bilskyi/yeti-keychain/case/yeti/latest/README.txt

ЙЕТИ-БРЕЛОК: 3 кнопки на животе + аккумулятор
================================================

Ремикс йети из проекта Compagnon 309 (MakerWorld, модель 2109424).
Только для себя: перед публикацией проверь лицензию на странице модели.
Подставка (диск со снегом и стойка) не входит, как просил.

ЧТО ПЕЧАТАТЬ  (папка print/)
----------------------------
Все файлы уже повёрнуты так, как их класть на стол. Не крути их в слайсере.

  Файл                                   Шт.  Поддержки
  1_body_with_3_buttons.stl               1   да, как у оригинала (*)
  2_back_plate_1xUSB-C_switch.stl         1   нет
  4_button_caps_x3.stl                    1   нет (3 колпачка в файле)
  5_screen_bezel_1.3in_original.stl       1   нет (оригинальная рамка экрана 1,3")

(*) Оригинальный корпус сам по себе требует поддержек внутри.
    Карманы под кнопки новых не добавляют.

Настройки: PLA или PETG, слой 0,2 мм, 3 периметра, заполнение 15-20 %.
Колпачки кнопок удобно печатать контрастным цветом.

ЧТО ПОНАДОБИТСЯ
---------------
  - ESP32-C3 Super Mini
  - OLED 1,3" 128x64 I2C (SH1106), 4 пина
  - плата зарядки TP4056 с USB-C и защитой DW01
  - LiPo-аккумулятор, не больше 20 x 33 x 6 мм (например 602030, 300 мА·ч)
  - движковый выключатель (SS12D00 или похожий)
  - 3 тактовые кнопки 6x6x5 мм
  - винты задней крышки к корпусу: как в оригинале
  - провода, термоусадка, немного клея и двусторонний скотч

СБОРКА
------
 1. Кнопки: вставь каждую в карман на животе снаружи, ножками в прорези.
    Если сидит свободно, капни клея на бок. Изнутри припаяй провода.
    Надень колпачки на штоки.
 2. Экран: рамку 5_screen_bezel вставь в окно корпуса изнутри, за ней экран
    стеклом к рамке.
 3. Электроника (рамки нет, крепи на клей и двусторонний скотч):
    TP4056 разъёмом USB-C в нижний карман задней крышки, разъём заподлицо
    с отверстием. Super Mini внутри, его USB-C наружу не выходит.
    Аккумулятор на скотч, выключатель в гнездо сбоку.
 4. Пропаяй всё по схеме ниже. Закрой крышку оригинальными винтами.

Сзади один USB-C: для зарядки (TP4056). Для прошивки сними заднюю крышку.

СХЕМА
-----
  OLED:      VCC -> 3V3, GND -> GND, SDA -> GPIO6, SCL -> GPIO7
  Кнопки:    GPIO1, GPIO3, GPIO5, вторая ножка каждой на GND
  Питание:   LiPo -> TP4056 B+/B-;  OUT+ -> выключатель -> 5V;  OUT- -> GND

  Прошивка наша (KEYCHAIN), не оригинальная от автора йети: у него другие пины.

ВАЖНО
-----
  - Никогда не втыкай USB в Super Mini при включённом выключателе: 5 В уйдут
    в аккумулятор. Перед прошивкой открой крышку и поставь выключатель OFF.
  - На TP4056 поменяй резистор Rprog с 1,2 кОм на 4,7-5,1 кОм. Иначе ток
    зарядки около 1 А, это слишком много для маленького аккумулятора.
  - Размеры TP4056, аккумулятора, выключателя и деталей на платах взяты
    типовые, а не измеренные. Если твои отличаются больше чем на 0,5 мм,
    пришли замеры, и я пересчитаю крышку.
