bilskyi/yeti-keychain/case/out/back.png

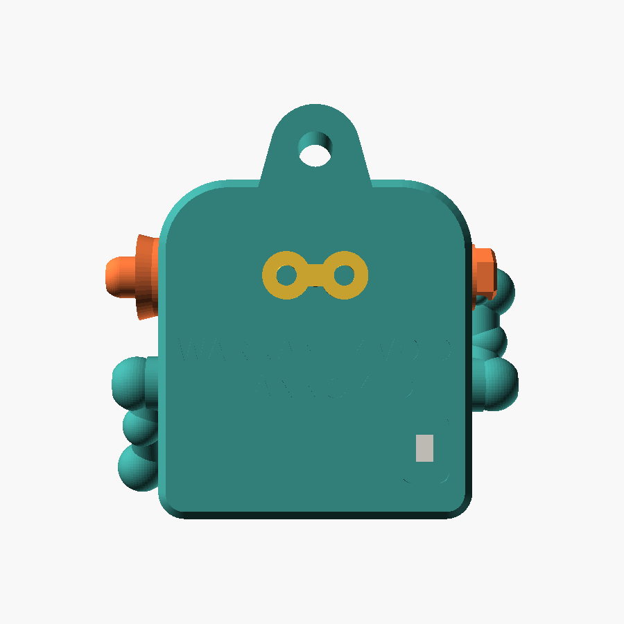
case/out/back.png
