bilskyi/yeti-keychain/case/out/concepts/arcade.png

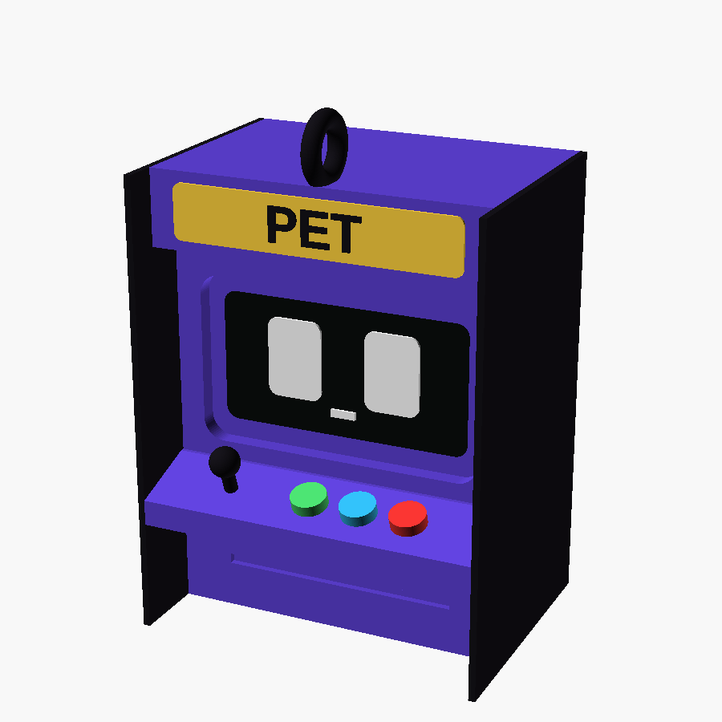
case/out/concepts/arcade.png
