bilskyi/yeti-keychain/case/out/concepts/burger.png

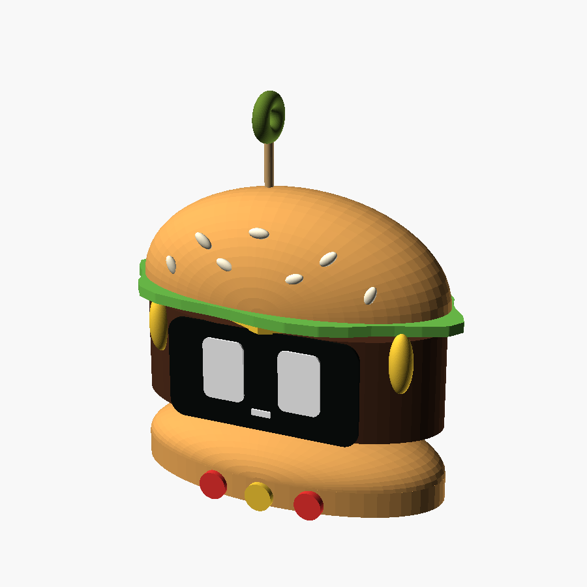
case/out/concepts/burger.png
