bilskyi/yeti-keychain/case/out/concepts/cassette.png

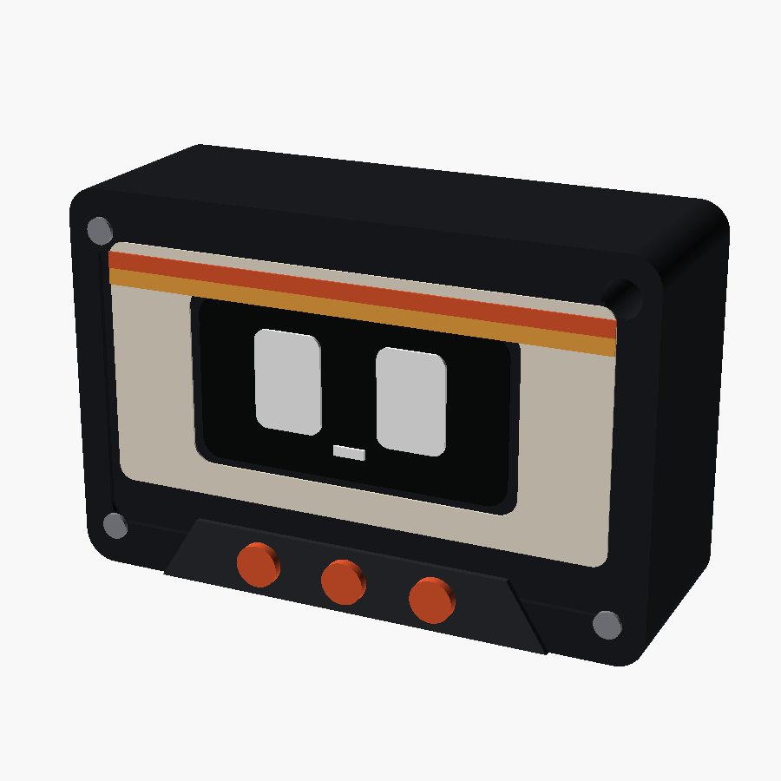
case/out/concepts/cassette.png
