bilskyi/yeti-keychain/case/out/concepts/cat.png

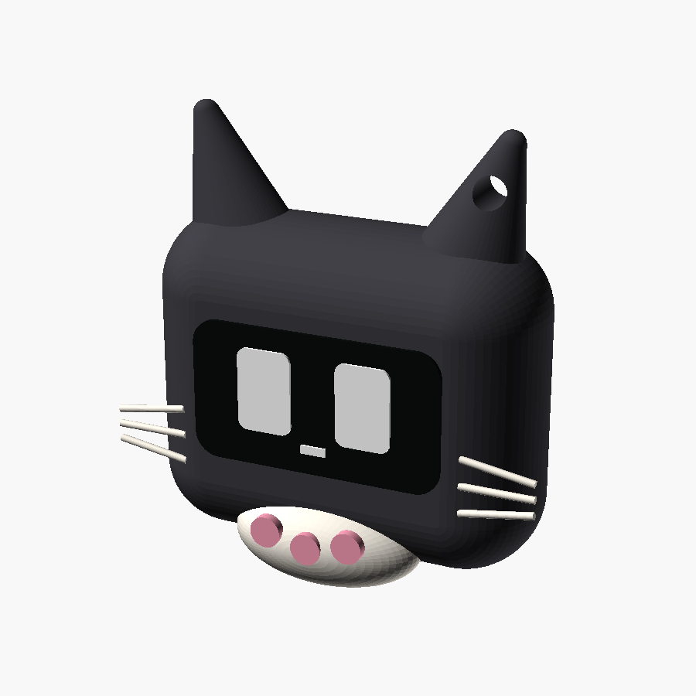
case/out/concepts/cat.png
