bilskyi/yeti-keychain/case/out/concepts/ghost.png

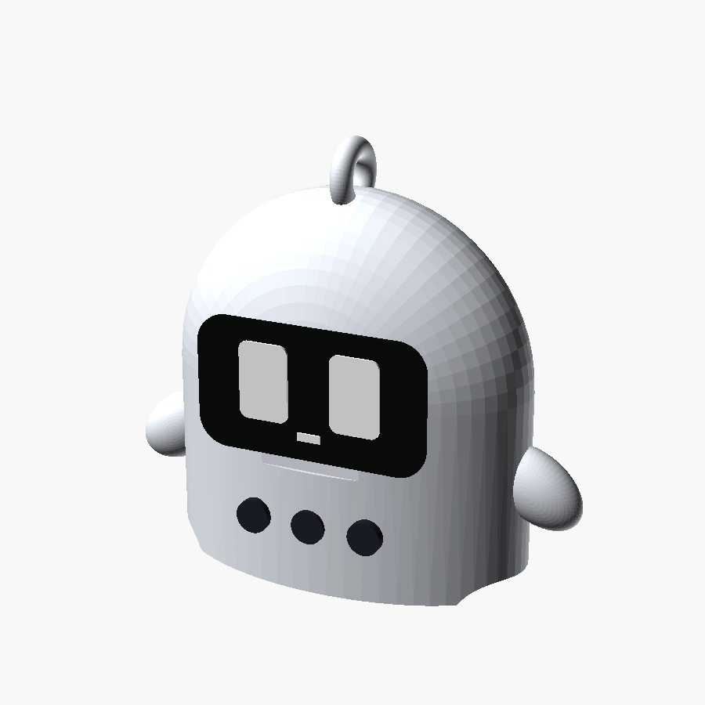
case/out/concepts/ghost.png
