bilskyi/yeti-keychain/case/out/concepts/helmet.png

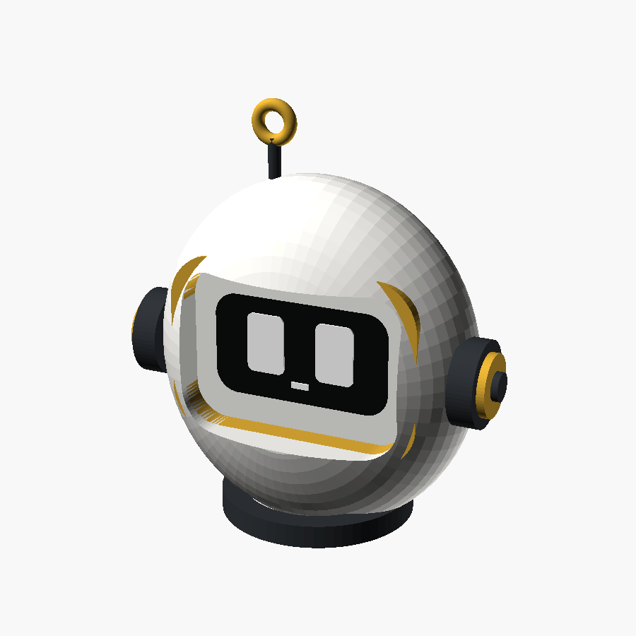
case/out/concepts/helmet.png
