bilskyi/yeti-keychain/case/out/concepts/poop.png

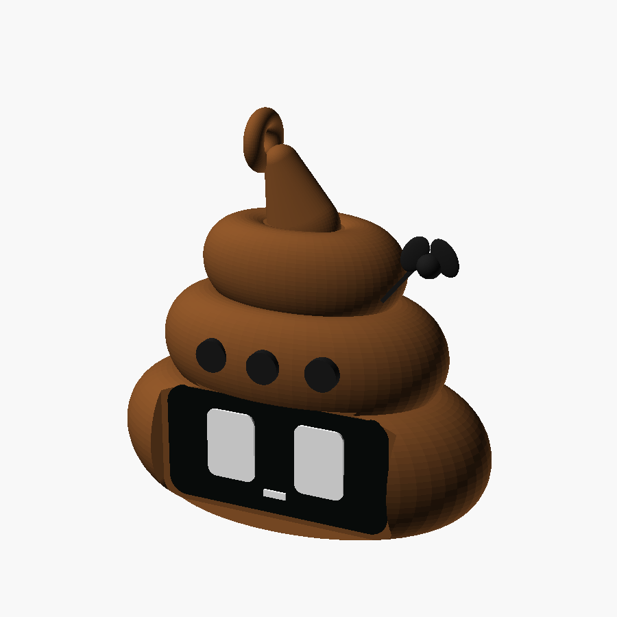
case/out/concepts/poop.png
