bilskyi/yeti-keychain/case/out/concepts/toast.png

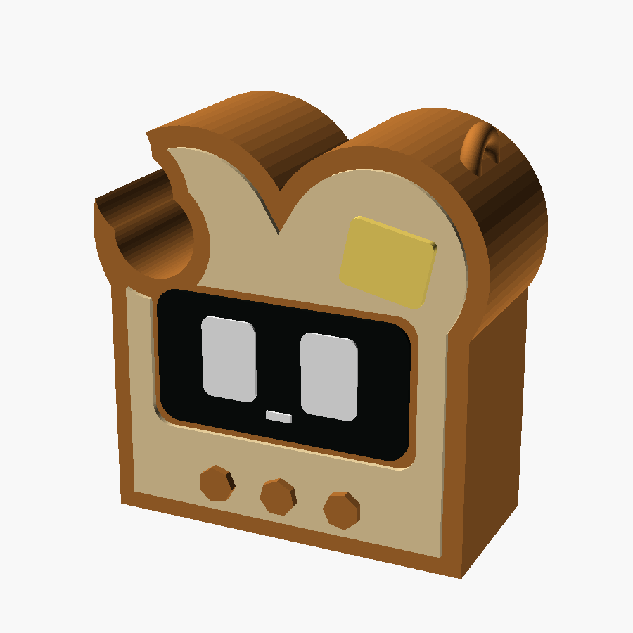
case/out/concepts/toast.png
