bilskyi/yeti-keychain/case/out/concepts/tv.png

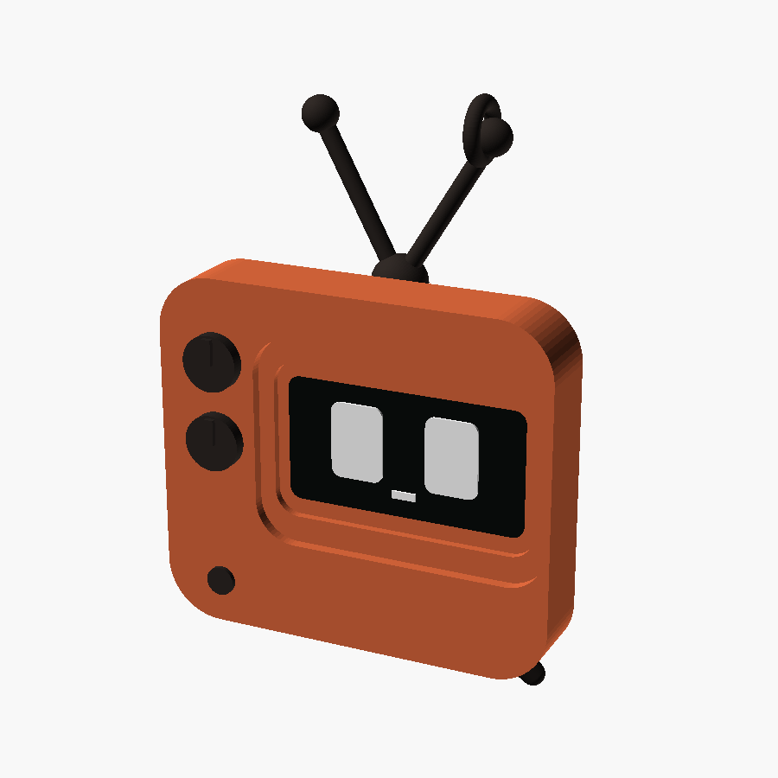
case/out/concepts/tv.png
