bilskyi/yeti-keychain/case/out/front.png

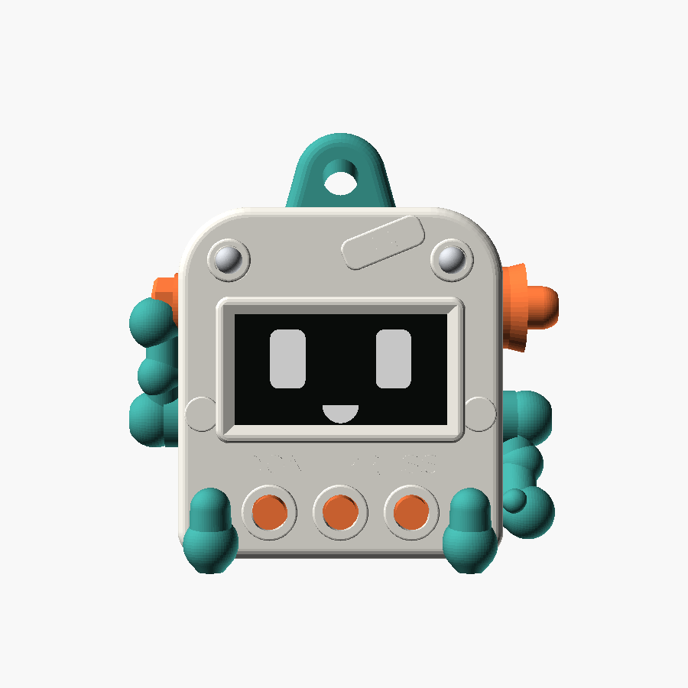
case/out/front.png
