bilskyi/yeti-keychain/case/out/hero.png

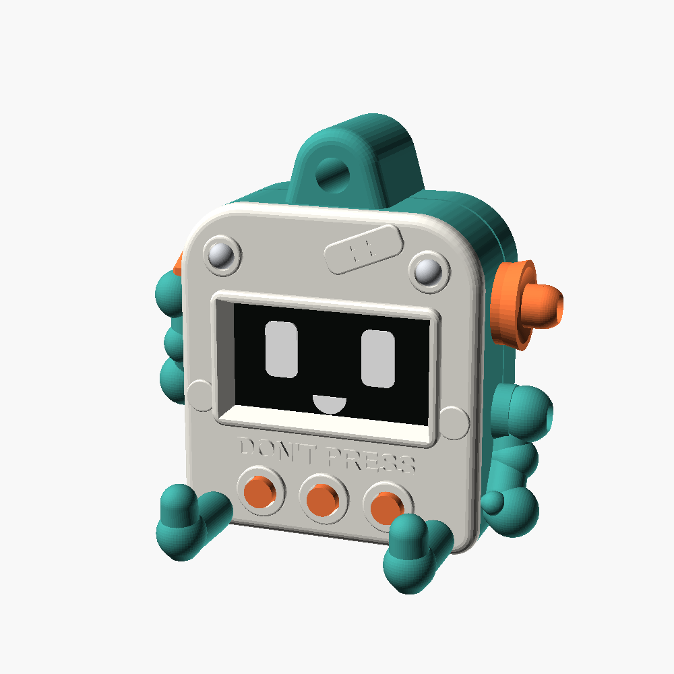
case/out/hero.png
