bilskyi/yeti-keychain/case/out/hero_rest.png

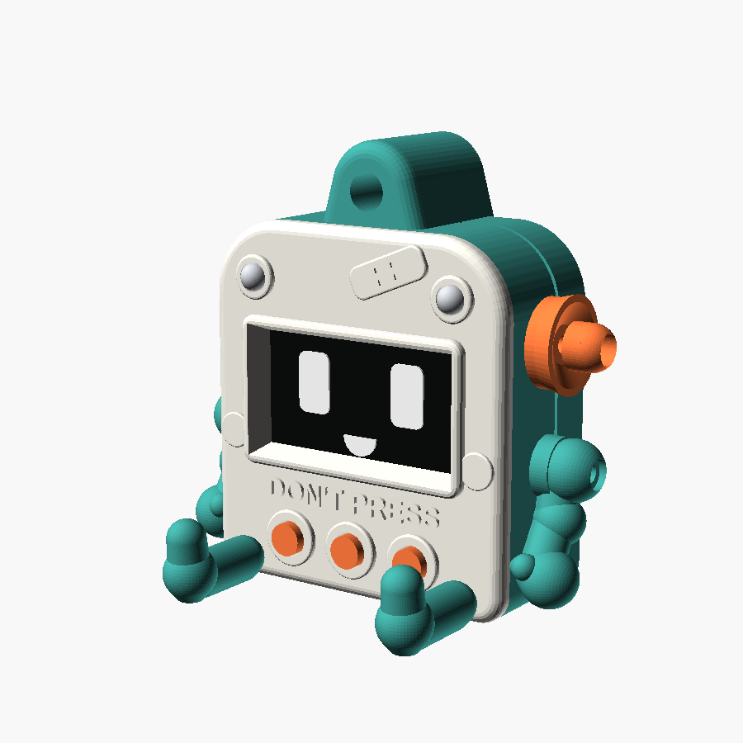
case/out/hero_rest.png
