bilskyi/yeti-keychain/case/out/side.png

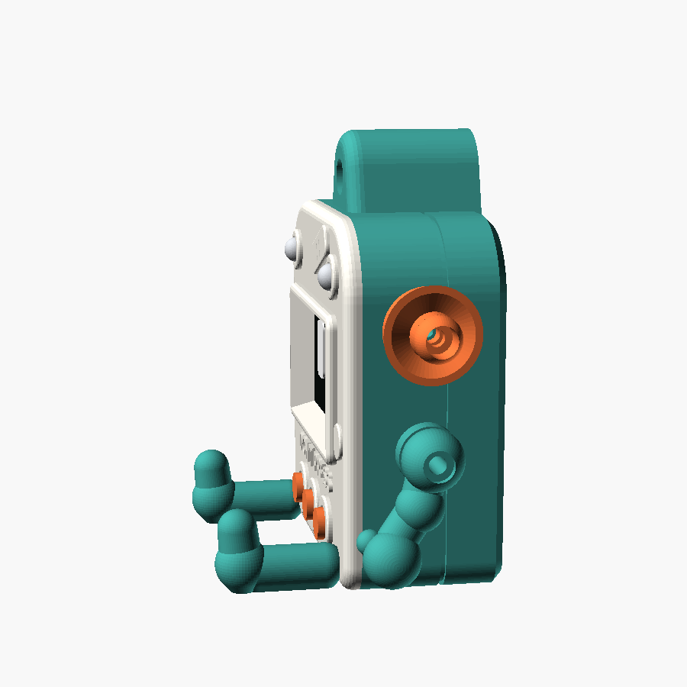
case/out/side.png
