bilskyi/yeti-keychain/case/yeti/out/look_back.png

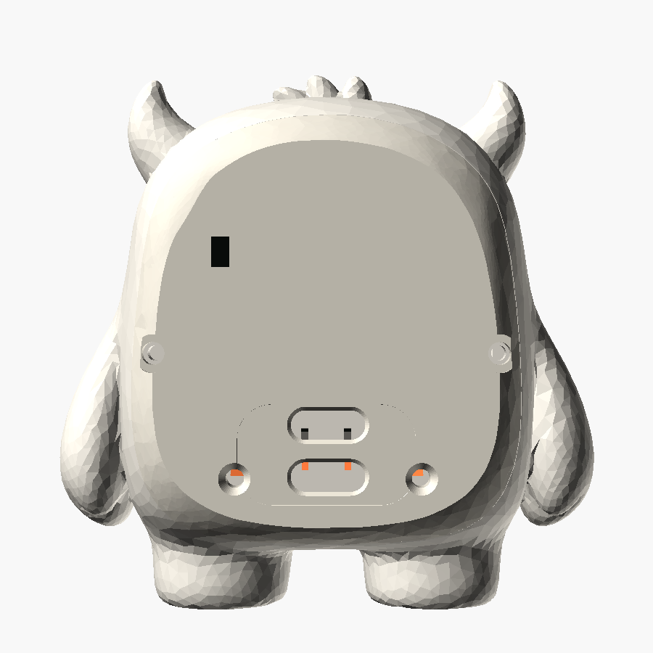
case/yeti/out/look_back.png
