bilskyi/yeti-keychain/case/yeti/out/look_bezel.png

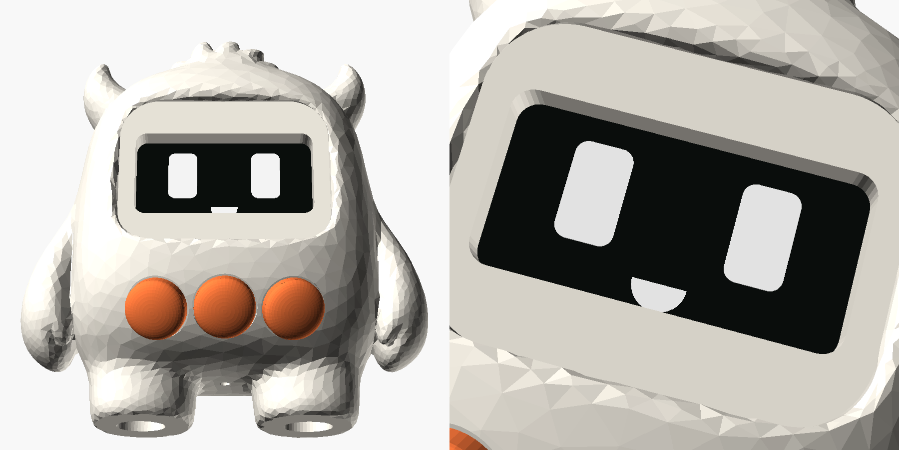
case/yeti/out/look_bezel.png
