bilskyi/yeti-keychain/case/yeti/out/look_closeup.png

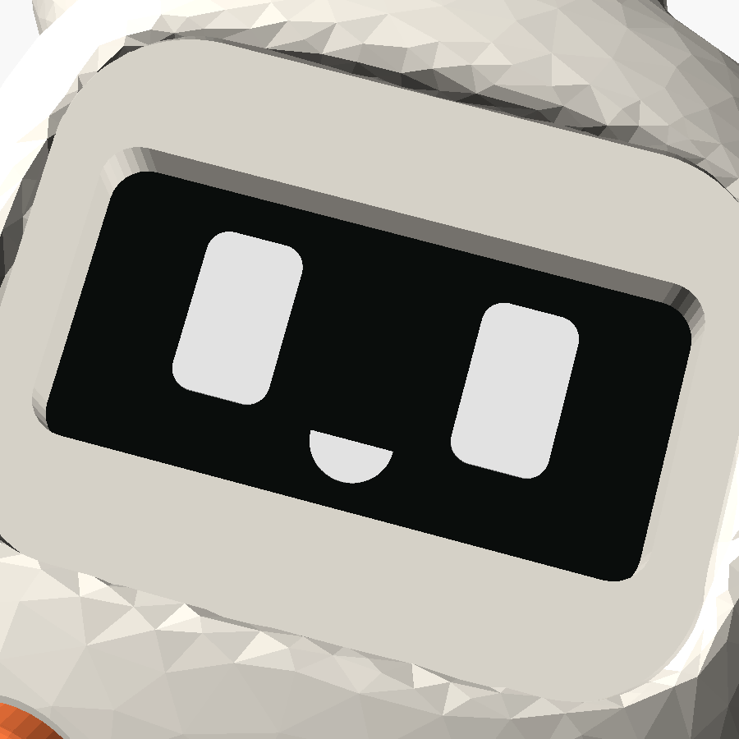
case/yeti/out/look_closeup.png
