bilskyi/yeti-keychain/case/yeti/out/look_front34.png

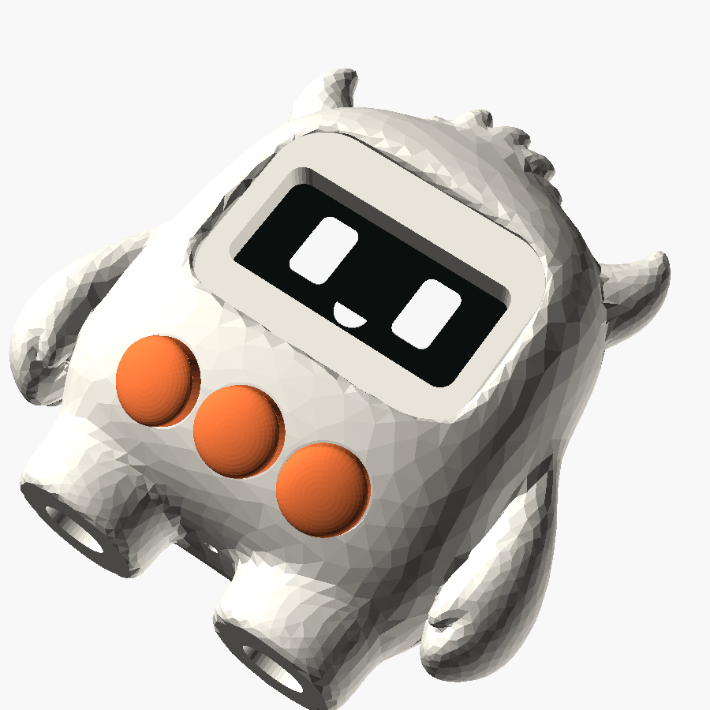
case/yeti/out/look_front34.png
