bilskyi/yeti-keychain/case/yeti/out/look_front.png

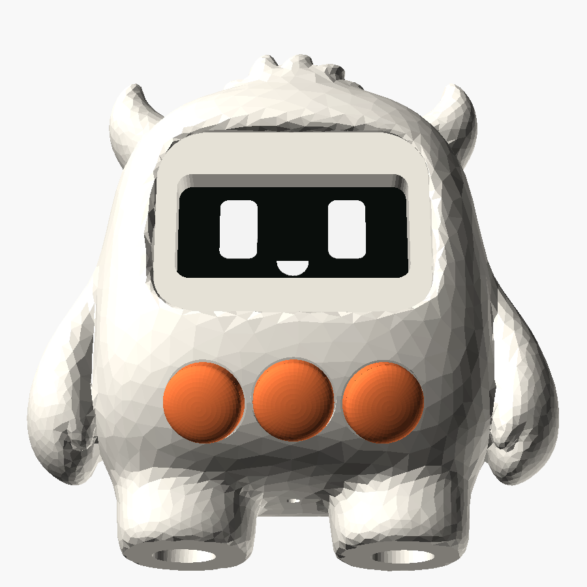
case/yeti/out/look_front.png
