bilskyi/yeti-keychain/case/yeti/out/look_others.png

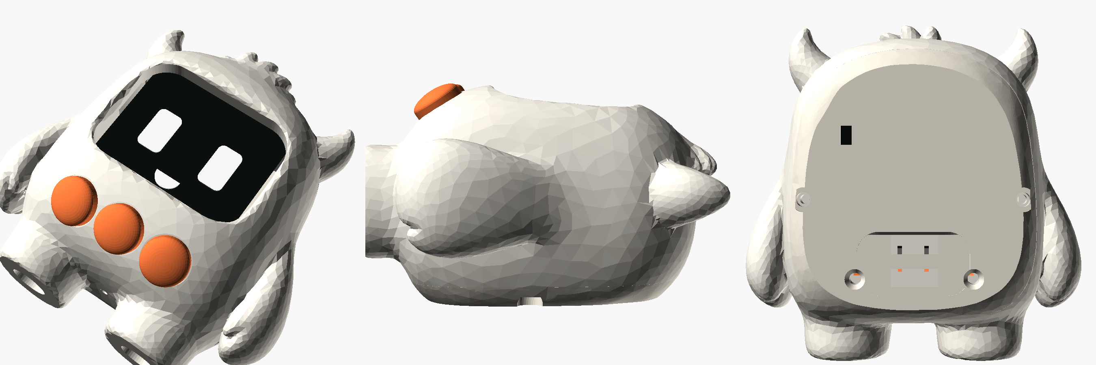
case/yeti/out/look_others.png
