bilskyi/yeti-keychain/case/yeti/out/look_side.png

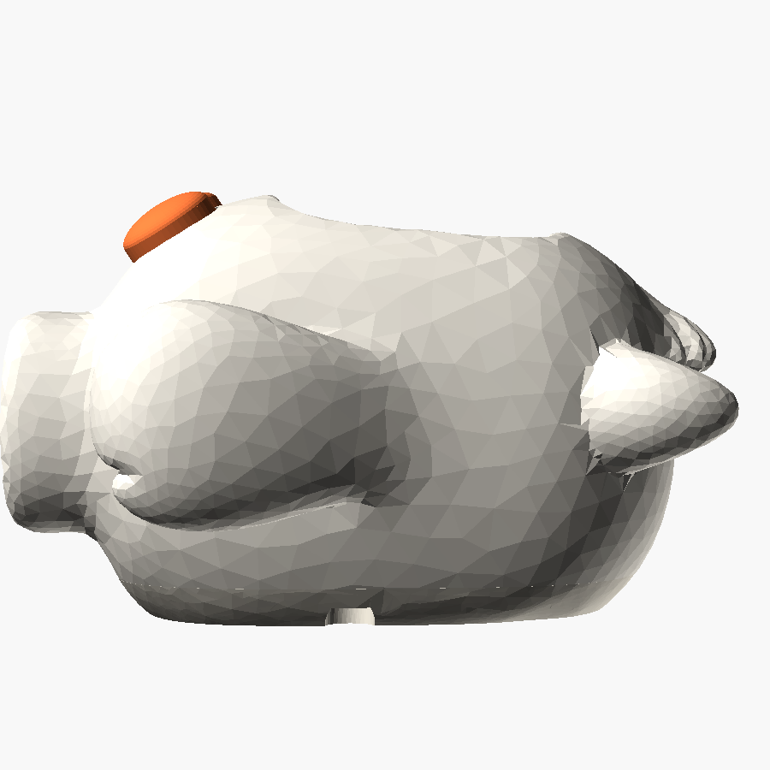
case/yeti/out/look_side.png
