bilskyi/yeti-keychain/case/yeti/out/module_back.png

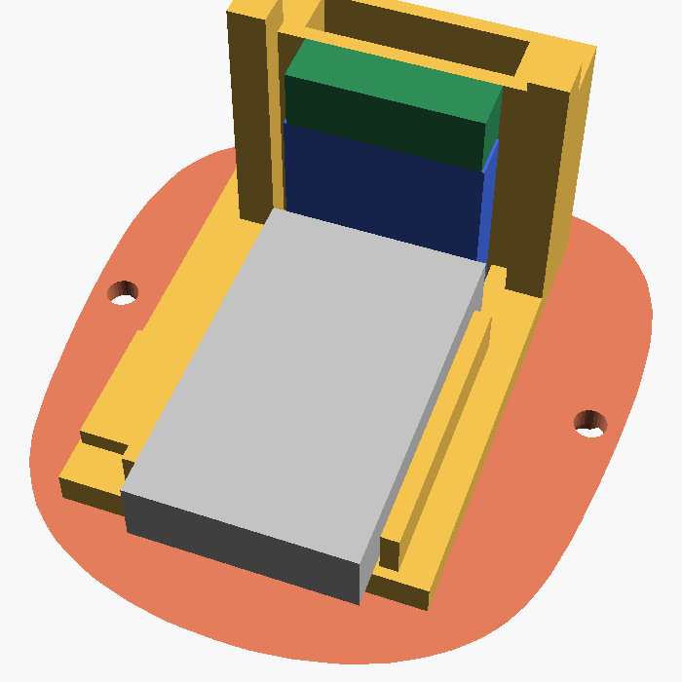
case/yeti/out/module_back.png
