bilskyi/yeti-keychain/case/yeti/out/module_front.png

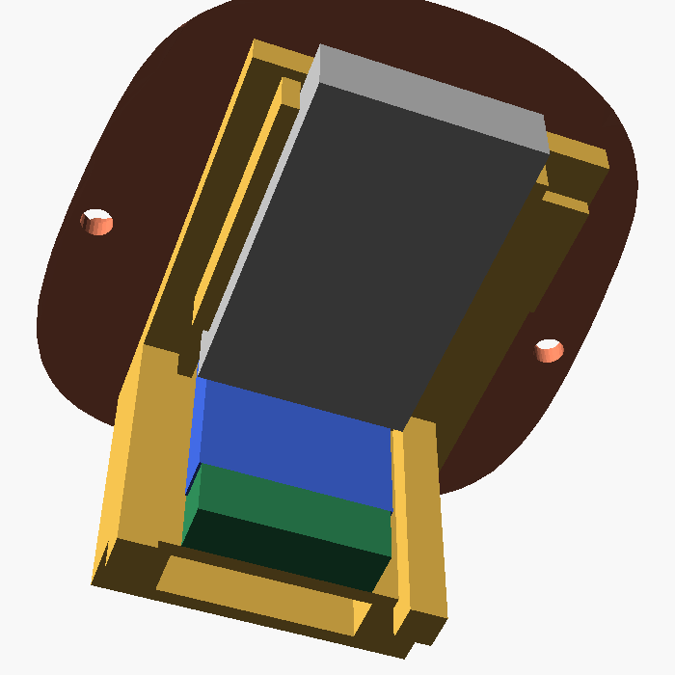
case/yeti/out/module_front.png
