bilskyi/yeti-keychain/case/yeti/out/module_views.png

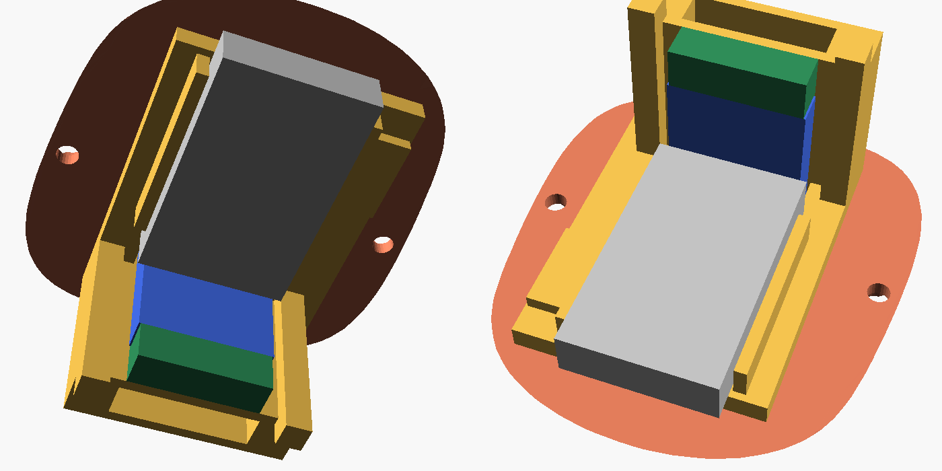
case/yeti/out/module_views.png
