bilskyi/yeti-keychain/case/yeti/out/power_back.png

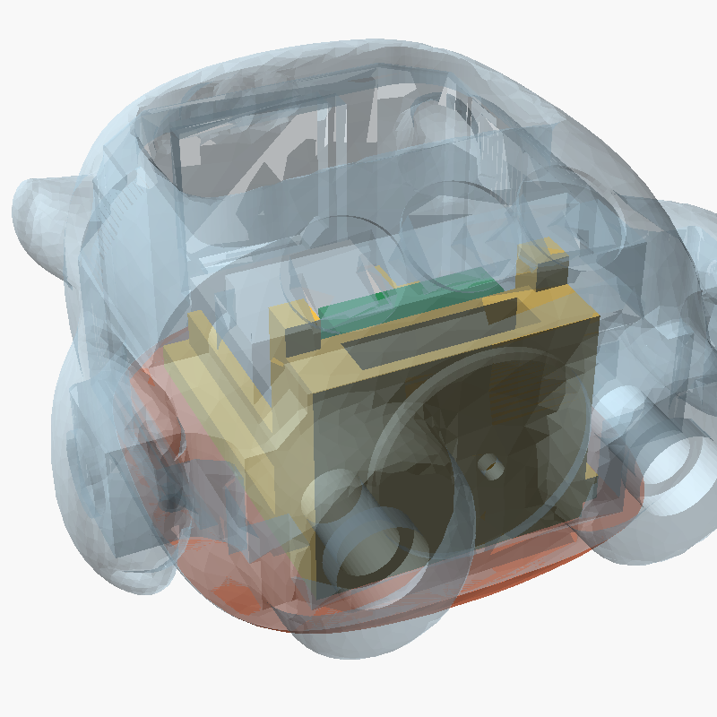
case/yeti/out/power_back.png
