bilskyi/yeti-keychain/case/yeti/out/power_section.png

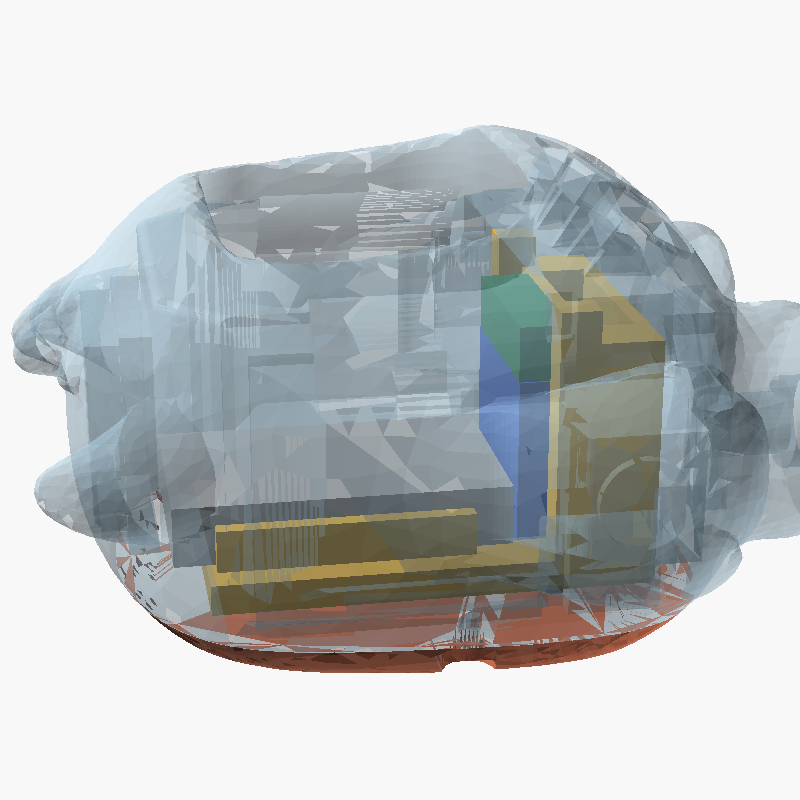
case/yeti/out/power_section.png
