bilskyi/yeti-keychain/case/yeti/out/power_views.png

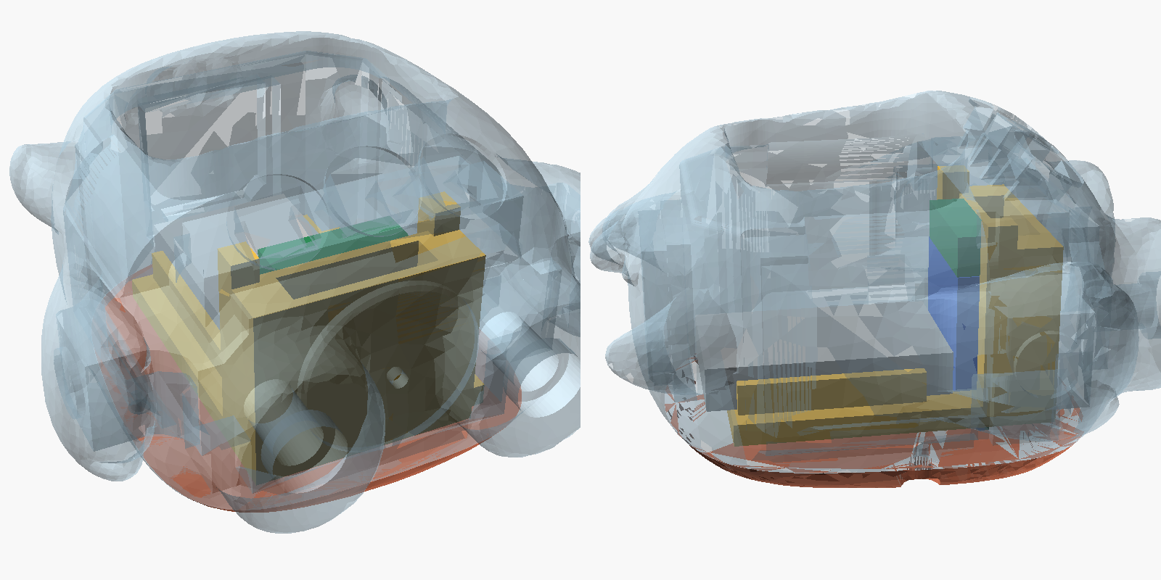
case/yeti/out/power_views.png
