bilskyi/yeti-keychain/case/yeti/out/preview_front.png

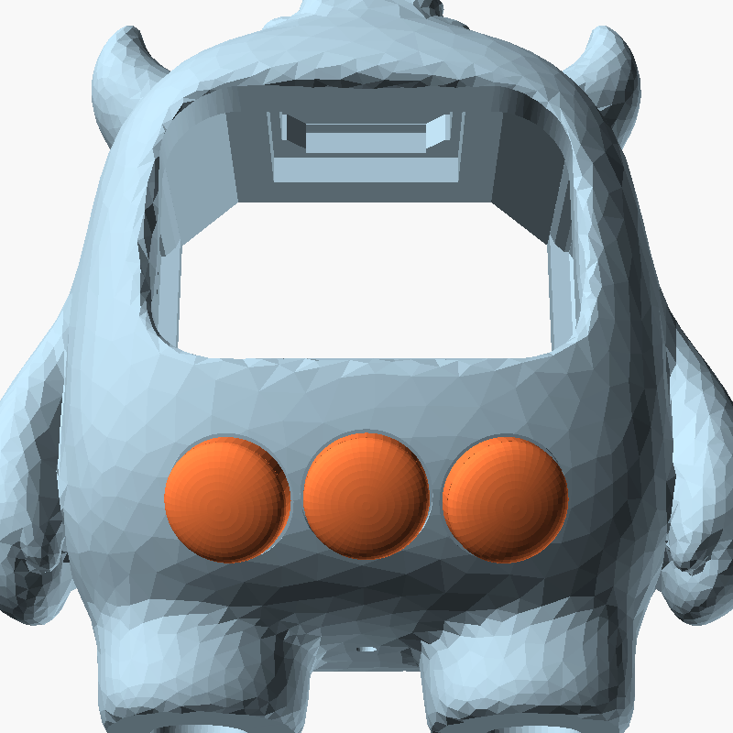
case/yeti/out/preview_front.png
