bilskyi/yeti-keychain/case/yeti/out/preview_section.png

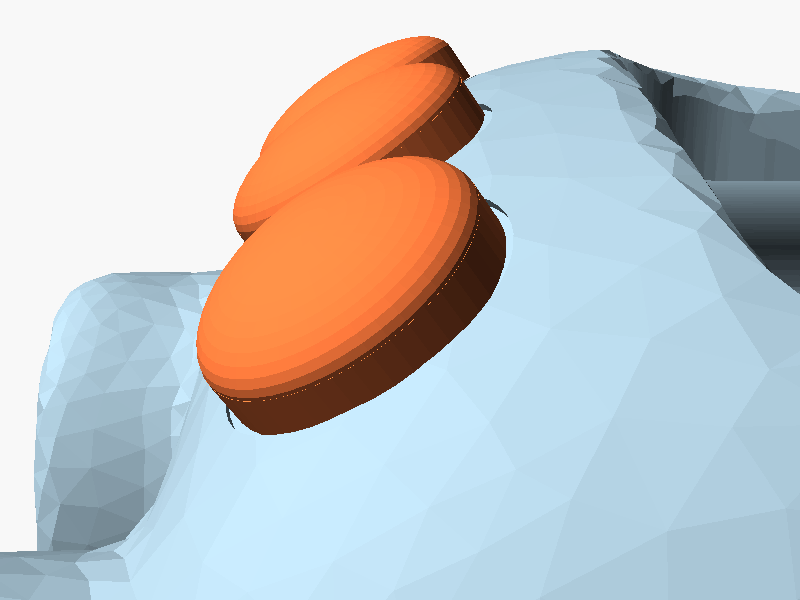
case/yeti/out/preview_section.png
