bilskyi/yeti-keychain/case/yeti/out/usb_ports.png

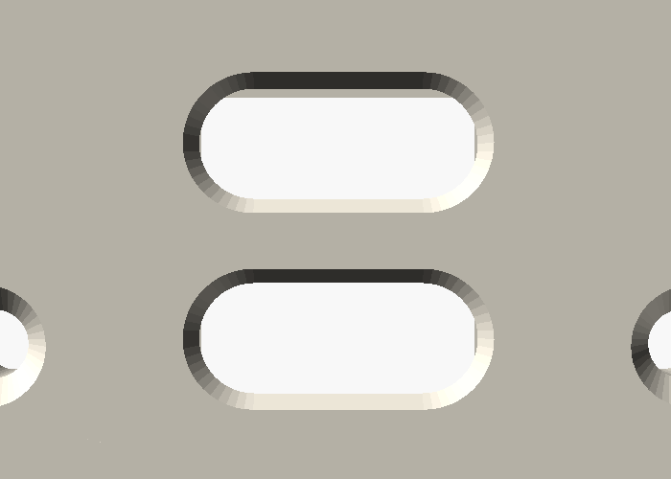
case/yeti/out/usb_ports.png
