bilskyi/yeti-keychain/case/out/arm_r.stl

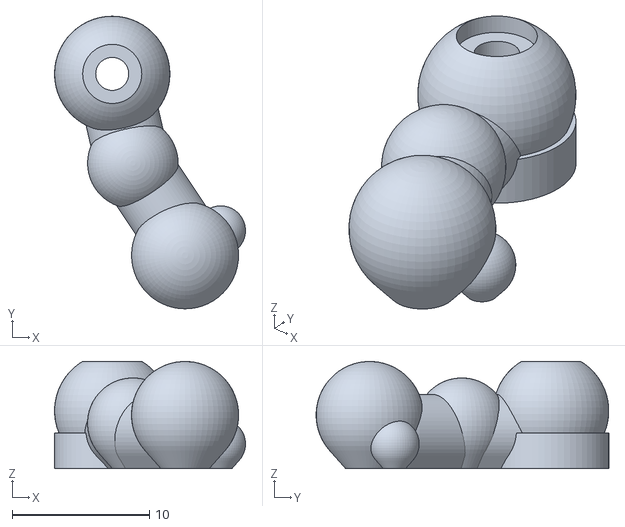
[picture p35: CAD file, 2026-10-23]
case/out/arm_r.stl
13.9 x 21.3 x 7.80
