bilskyi/yeti-keychain/case/yeti/latest/print/2_back_plate_1xUSB-C_switch.stl

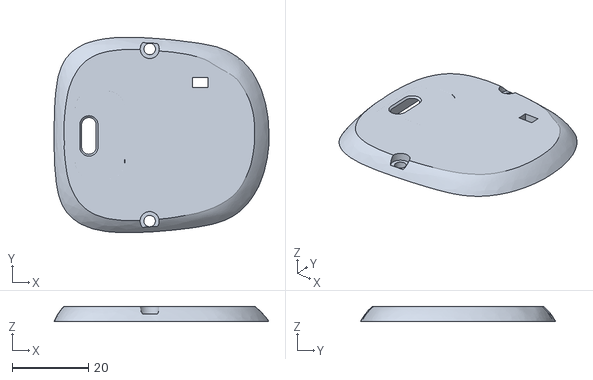
[picture p36: CAD file, 2026-11-09]
case/yeti/latest/print/2_back_plate_1xUSB-C_switch.stl
56.2 x 51.1 x 4.00
