bilskyi/yeti-keychain/case/out/body.stl

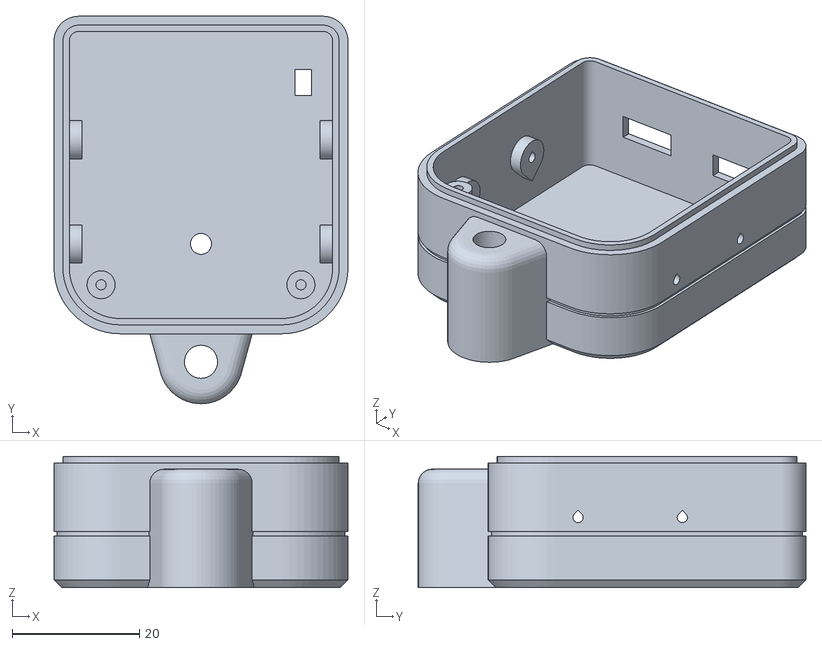
[picture p37: CAD file, 2026-10-23]
case/out/body.stl
46.2 x 60.9 x 20.6
