bilskyi/yeti-keychain/case/yeti/latest/print/4_button_caps_x3.stl

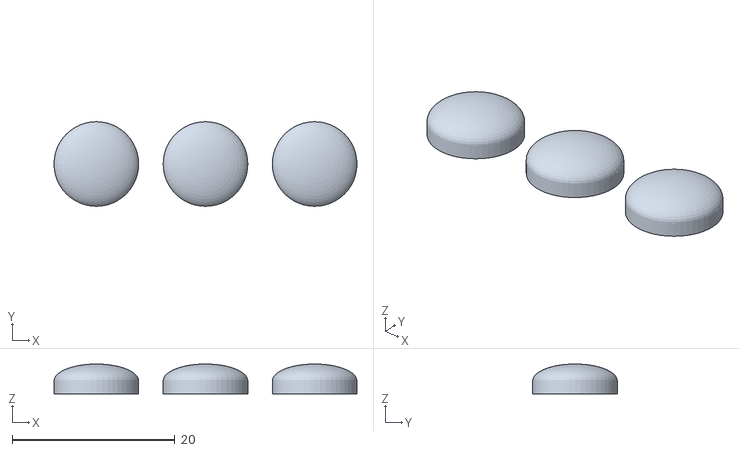
[picture p38: CAD file, 2026-11-09]
case/yeti/latest/print/4_button_caps_x3.stl
37.2 x 10.4 x 3.68
