bilskyi/yeti-keychain/case/yeti/out/yeti_carrier.stl

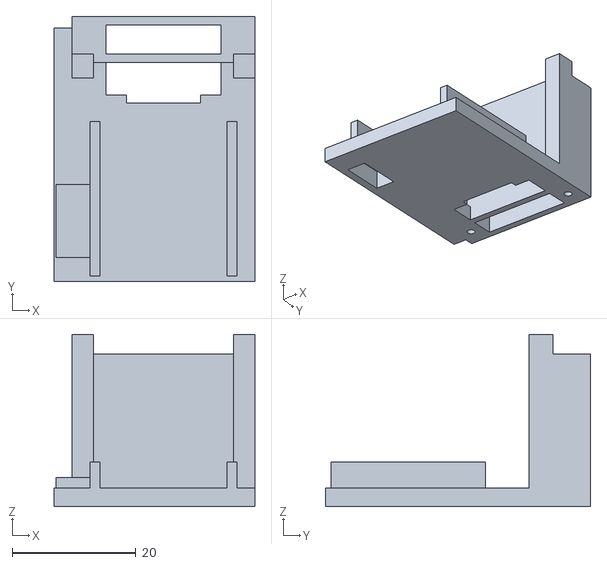
[picture p39: CAD file, 2026-10-23]
case/yeti/out/yeti_carrier.stl
32.5 x 42.9 x 27.9
