bilskyi/yeti-keychain/case/yeti/latest/print/5_screen_bezel_1.3in_original.stl

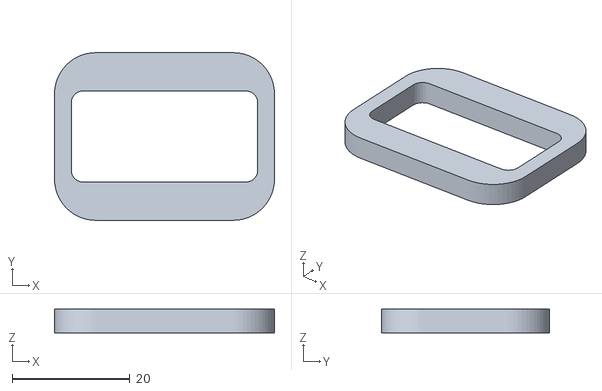
[picture p40: CAD file, 2026-11-09]
case/yeti/latest/print/5_screen_bezel_1.3in_original.stl
37.4 x 28.5 x 4.00
