bilskyi/yeti-keychain/case/yeti/out/yeti_body_buttons.stl

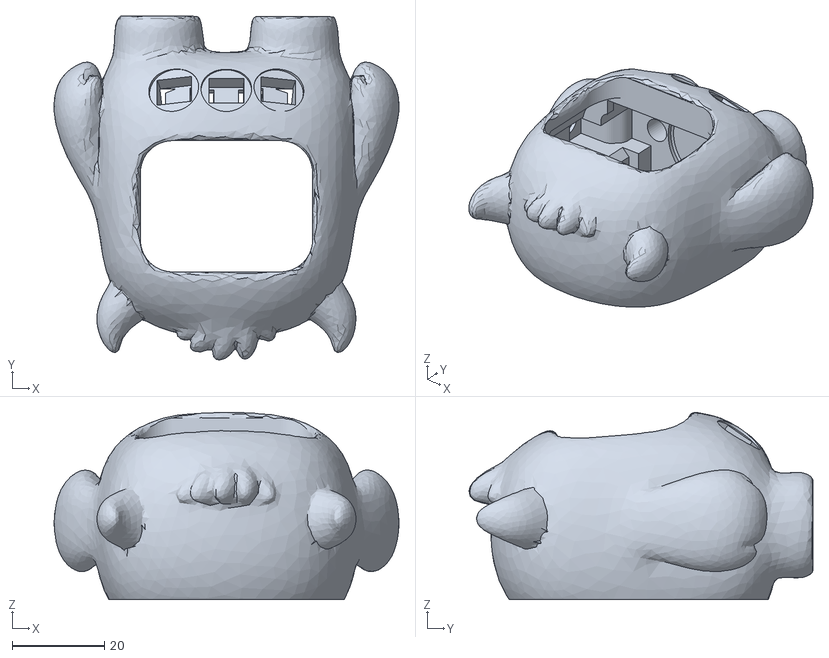
[picture p41: CAD file, 2026-10-23]
case/yeti/out/yeti_body_buttons.stl
74.9 x 74.7 x 40.6
