bilskyi/yeti-keychain/case/out/plate.stl

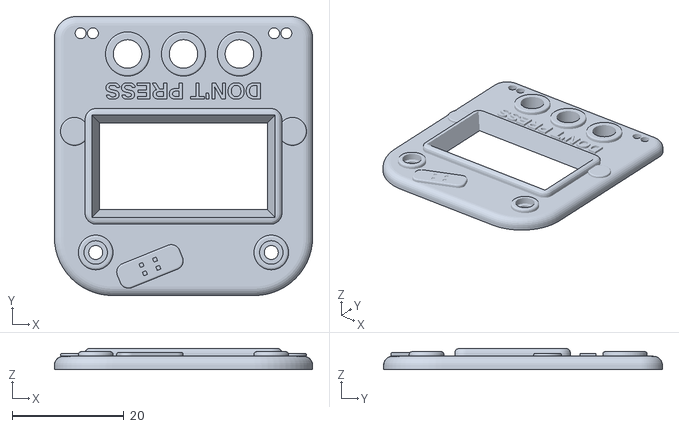
[picture p42: CAD file, 2026-10-23]
case/out/plate.stl
46.2 x 49.9 x 3.81
