bilskyi/yeti-keychain/case/out/ear_dish.stl

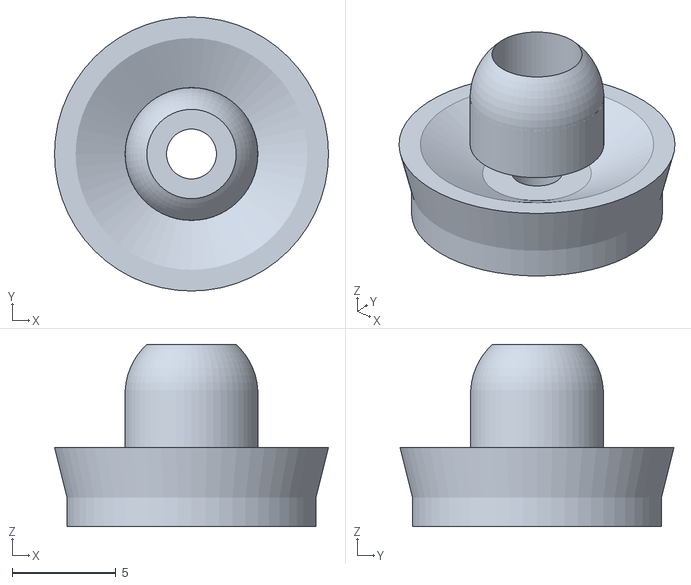
[picture p43: CAD file, 2026-10-23]
case/out/ear_dish.stl
13.2 x 13.2 x 8.77
