bilskyi/yeti-keychain/case/out/leg.stl

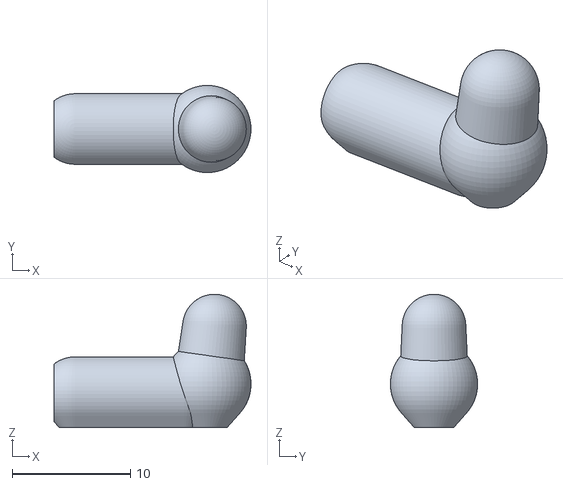
[picture p44: CAD file, 2026-10-23]
case/out/leg.stl
16.7 x 7.39 x 11.3
