bilskyi/yeti-keychain/case/out/spacers.stl

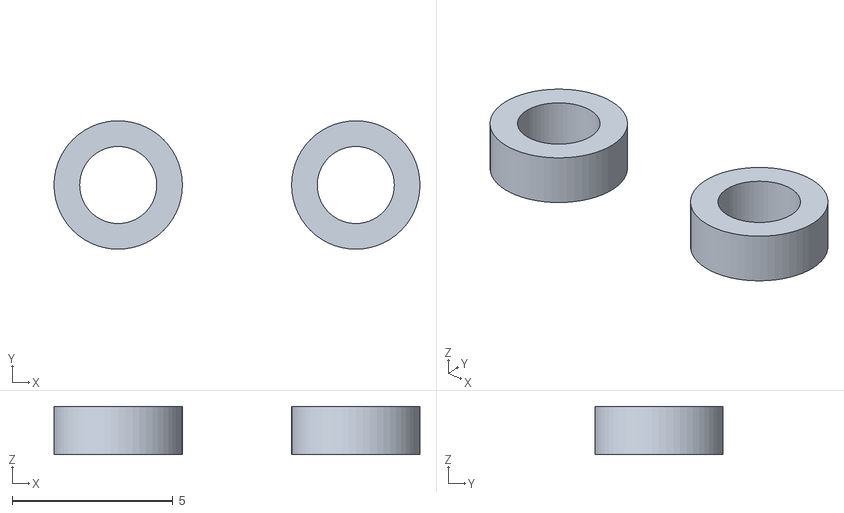
[picture p45: CAD file, 2026-10-23]
case/out/spacers.stl
11.4 x 4.00 x 1.50
