bilskyi/yeti-keychain/case/out/key.stl

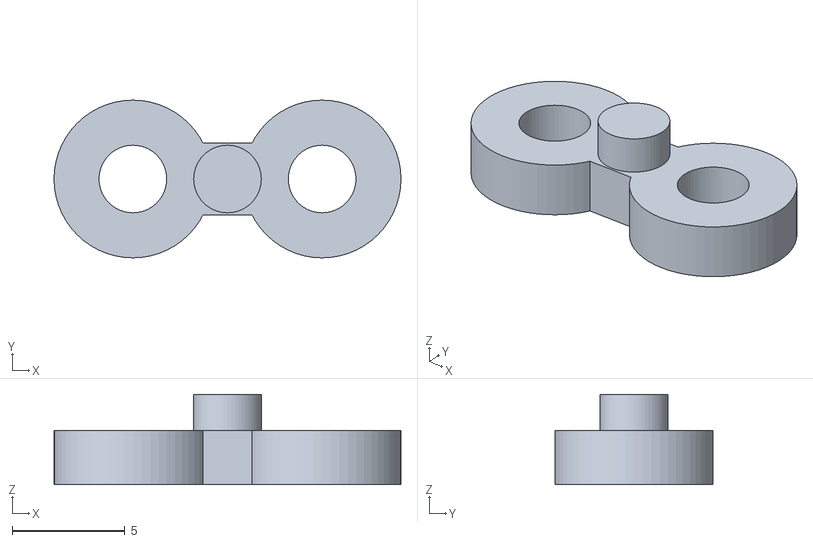
[picture p46: CAD file, 2026-10-23]
case/out/key.stl
15.4 x 7.00 x 4.00
