bilskyi/yeti-keychain/case/out/caps.stl

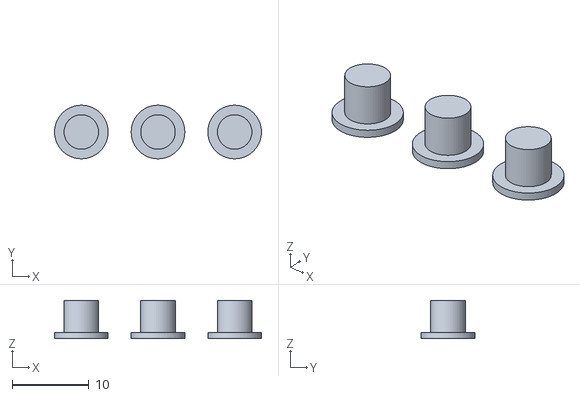
[picture p47: CAD file, 2026-10-23]
case/out/caps.stl
27.0 x 7.00 x 5.00
