bilskyi/yeti-keychain/case/out/ear_bolt.stl

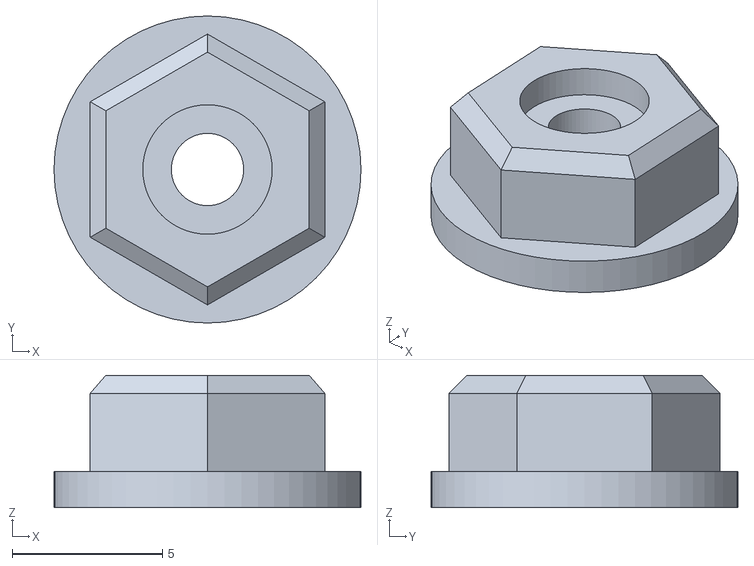
[picture p48: CAD file, 2026-10-23]
case/out/ear_bolt.stl
10.2 x 10.2 x 4.40
