bilskyi/yeti-keychain/(list of files, cad)

Other CAD files:
case/yeti/out/yeti_back_plate.stl
case/out/arm_l.stl
case/yeti/latest/print/1_body_with_3_buttons.stl
case/yeti/out/yeti_caps.stl
