bilskyi/yeti-keychain/case/out/assembly_cutaway.png

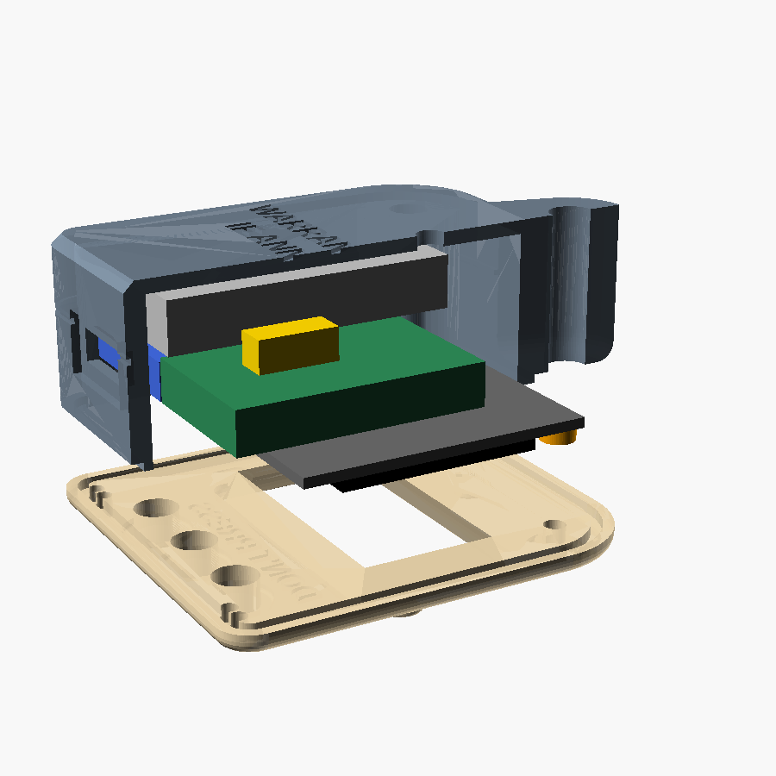
case/out/assembly_cutaway.png
