bilskyi/yeti-keychain/docs/guide/yeti-guide-80mm.pdf

# Как со мной дружить

A

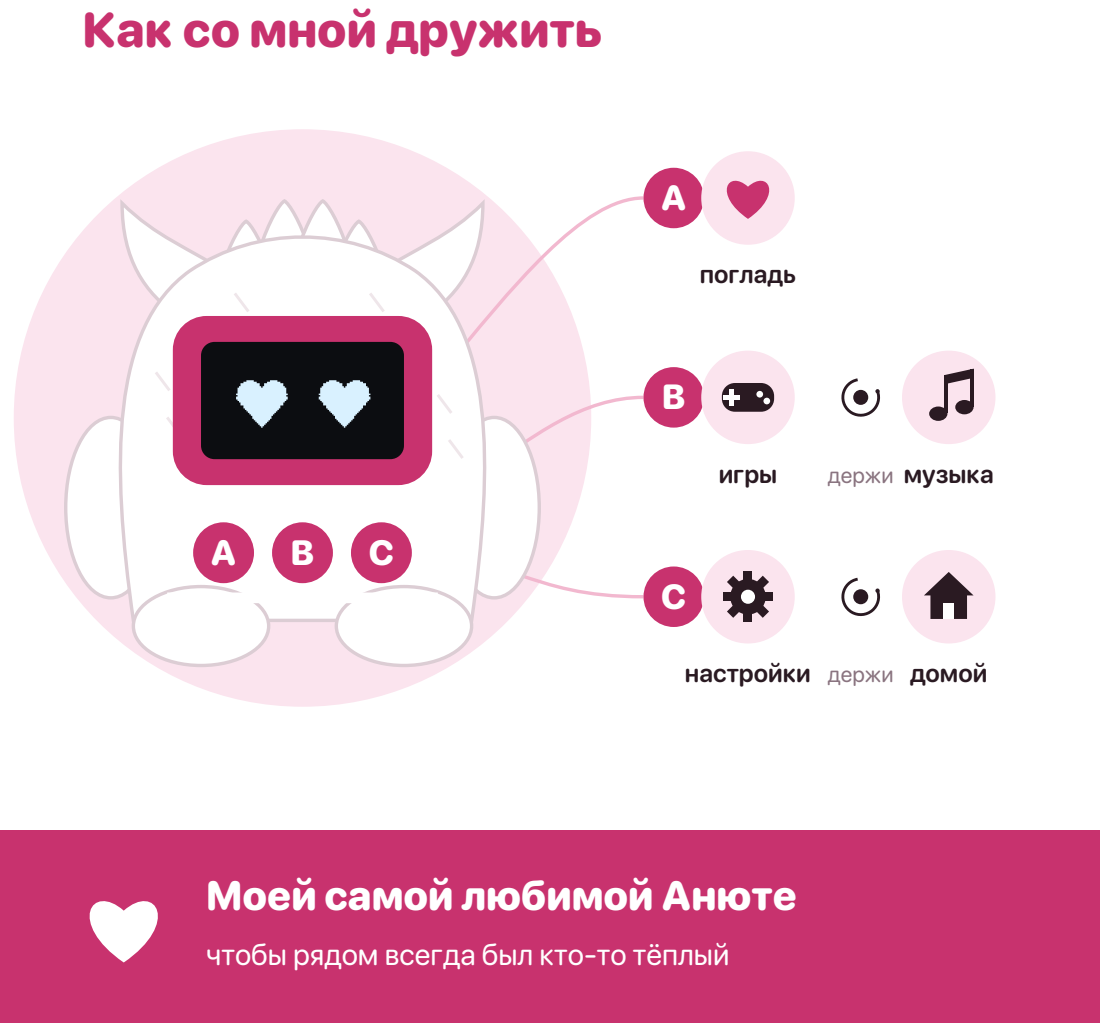
[picture p50: page 1]
погладь; игры; держи музыка

настройки держи домой

Моей самой любимой Анюте
чтобы рядом всегда был кто-то тёплый

# Я живой

погладь
мурчит

потряси
кружится

переверни
пугается

поговори
отвечает

## Зарядка

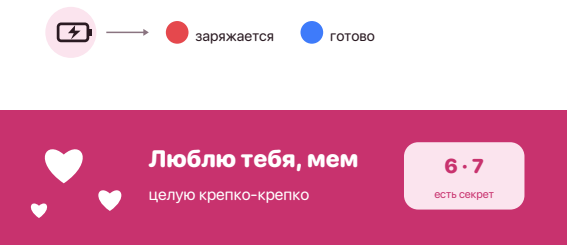
[picture p51: figure]
заряжается; готово; Люблю тебя, мем; целую крепко-крепко; есть секрет
