bilskyi/yeti-keychain/docs/guide/yeti-guide-a5.pdf

## Как со мной дружить

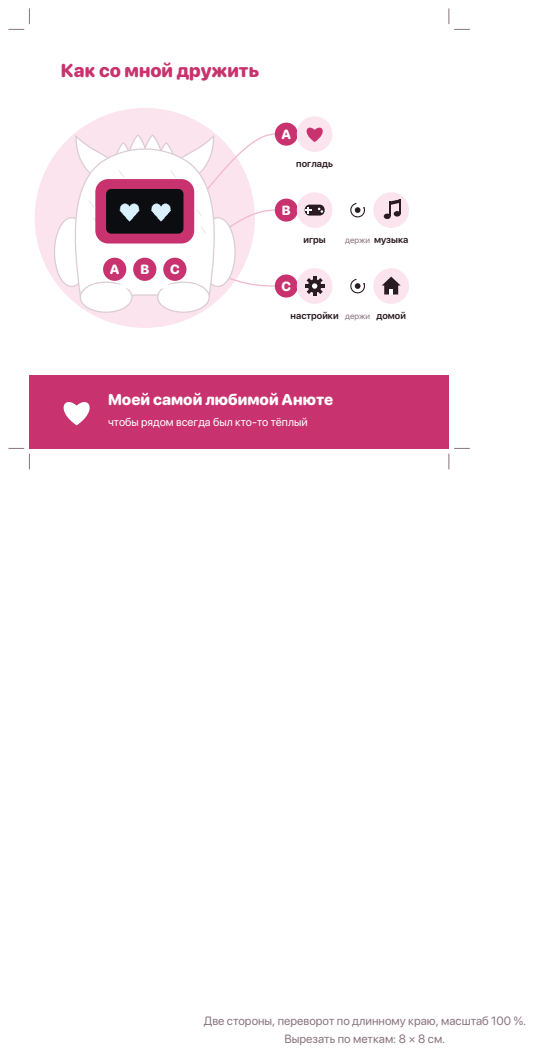
[picture p52: page 1]
погладь; игры; держи музыка

настройки держи домой

Моей самой любимой Анюте
чтобы рядом всегда был кто-то тёплый

Две стороны, переворот по длинному краю, масштаб 100 %.

Вырезать по меткам: 8 × 8 см.

## Я живой

погладь
мурчит

потряси
кружится

переверни
пугается

поговори
отвечает

### Зарядка

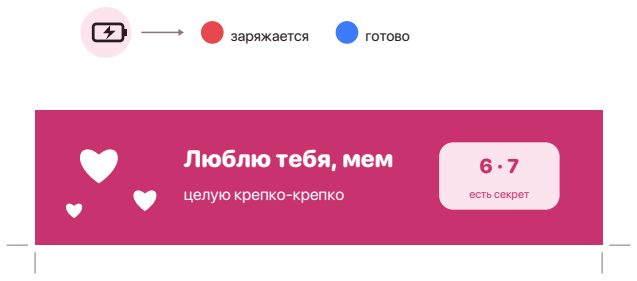
[picture p53: figure]
заряжается; готово; Люблю тебя, мем; целую крепко-крепко; есть секрет

Две стороны, переворот по длинному краю, масштаб 100 %. Вырезать по меткам: 8 × 8 см.
