bilskyi/yeti-keychain/main/config.h

// Everything a person might want to change lives here: pins, which panel is
// fitted, feature flags, and the timing of the face and the power policy.
//
// Plain macros only, no ESP-IDF headers, so the host tests can include it too.
//
// Every flag can be overridden from the build without editing this file:
//   idf.py -B build-allon -DKC_FEATURES="FEATURE_BUTTONS=1;FEATURE_ACCEL=1" build

#pragma once

// ---------------------------------------------------------------------------
// Display driver. 1.3" modules are almost always SH1106. If the picture is
// shifted ~2 px sideways with a garbage column at one edge, or is garbled,
// the panel is an SSD1306: change this one line.
// ---------------------------------------------------------------------------
#define DISPLAY_SH1106 1
#define DISPLAY_SSD1306 2

#ifndef DISPLAY_DRIVER
#define DISPLAY_DRIVER DISPLAY_SH1106
#endif

#define DISPLAY_I2C_ADDR 0x3C  // the other common strap is 0x3D; init probes both
#define DISPLAY_I2C_HZ 400000
#ifndef DISPLAY_UPSIDE_DOWN
#define DISPLAY_UPSIDE_DOWN 1  // the OLED is soldered in rotated 180 degrees
#endif

// ---------------------------------------------------------------------------
// Pins (fixed wiring, see docs/WIRING.md). Do not change without re-wiring.
// GPIO2, GPIO8, GPIO9 are strapping pins (GPIO8 also drives the onboard LED):
// never use them. Only GPIO0-5 can wake the C3 from deep sleep.
// ---------------------------------------------------------------------------
#define PIN_I2C_SDA 6
#define PIN_I2C_SCL 7

// Left to right on the case: A, B, C. All to GND, internal pull-ups.
#define PIN_BTN_A 20  // was the red LED's pin (LED off the board for now); no deep-sleep wake
#define PIN_BTN_B 3
#define PIN_BTN_C 1
#define PIN_ACCEL_INT1 0     // LIS3DH INT1, same I2C bus as the OLED
#define PIN_BATTERY_ADC 2    // 5.1k/5.1k divider from the 5V pin (after the switch), ADC1 channel 2
#define PIN_CHARGE_SENSE 21  // TP4056 IN+ - 5.1k - here - 2 x 5.1k - GND: high while the charging cable is in
#define PIN_BUZZER 10        // passive buzzer, LEDC PWM; not a wake source
// Buzzer's other leg: -1 = on GND (current wiring; loud enough per Sasha).
// Set 21 and move the leg to GPIO21 for a bridge: the second pin is driven in
// antiphase, doubling the voltage across the buzzer with no transistor.
#define PIN_BUZZER_BRIDGE -1
#define PIN_LED 20  // red LED (not fitted now: button A has the pin, FEATURE_LED 0)
#define PIN_TOUCH 5  // TTP223 I/O (high while touched); internal pull-down when absent
#define PIN_MIC 4    // MAX4466-type analog mic OUT, ADC1 channel 4 (biased at ~1.65 V)

// ---------------------------------------------------------------------------
// Feature flags. Display is always on. Buttons, LIS3DH and buzzer are fitted
// (Phase 2); a missing part only logs a warning at boot.
// ---------------------------------------------------------------------------
#ifndef FEATURE_BUTTONS
#define FEATURE_BUTTONS 1
#endif
#ifndef FEATURE_ACCEL
#define FEATURE_ACCEL 1
#endif
#ifndef FEATURE_SOUND
#define FEATURE_SOUND 1
#endif
#ifndef FEATURE_LED
#define FEATURE_LED 0
#endif
// Touch pad and microphone: safe to leave on when not fitted. The touch pin
// is pulled down (never touched); the mic is checked at boot and switched
// off if the pin reads ~0 V instead of the mic's mid-rail bias.
#ifndef FEATURE_TOUCH
#define FEATURE_TOUCH 1
#endif
#ifndef FEATURE_MIC
#define FEATURE_MIC 1
#endif
#ifndef FEATURE_BATTERY_ADC
#define FEATURE_BATTERY_ADC 1
#endif
// Charger sense on PIN_CHARGE_SENSE: wired 2026-10-28. Reads low
// (internal pull-down) without the wire, so turning it on early is harmless.
#ifndef FEATURE_CHARGE_SENSE
#define FEATURE_CHARGE_SENSE 1
#endif
#ifndef FEATURE_WIFI
#define FEATURE_WIFI 0
#endif
#ifndef FEATURE_BLE
#define FEATURE_BLE 0
#endif
// BIT, the desk robot, over ESP-NOW (link/buddy.h): throw it things, play it at
// Pong. The radio only wakes to send unless a BIT screen is up.
#ifndef FEATURE_BUDDY
#define FEATURE_BUDDY 1
#endif

// Updating over WiFi (net/update.h): Settings > UPDATE makes a WiFi of its own
// to upload a new .bin to. Off until chosen.
#ifndef FEATURE_UPDATE
#define FEATURE_UPDATE 1
#endif

// ---------------------------------------------------------------------------
// LED (FEATURE_LED). There is no series resistor: the weakest pad drive
// (about 5 mA source) is what limits the current, and PWM keeps the average
// lower still. Don't raise LED_DRIVE_CAP without adding a resistor (~100 R).
// ---------------------------------------------------------------------------
#define LED_DRIVE_CAP 0
#define LED_MAX_PCT 60  // PWM duty at "full" brightness

#if FEATURE_LED && FEATURE_BUTTONS && (PIN_LED == PIN_BTN_A || PIN_LED == PIN_BTN_C)
#error "The LED and button C both on one pin: move one (docs/WIRING.md)"
#endif
#if FEATURE_MIC && FEATURE_BATTERY_ADC && PIN_MIC == PIN_BATTERY_ADC
#error "the mic and the battery sense share GPIO4: move one (both need ADC1 = GPIO0-4)"
#endif

// ---------------------------------------------------------------------------
// Touch pad (FEATURE_TOUCH): TTP223 on the head
// ---------------------------------------------------------------------------
// Short touch = TOUCH; held for BTN_LONG_MS = TOUCH_HOLD (petting), then
// TOUCH_END on release; TOUCH_TICKLE_COUNT short touches within
// TOUCH_TICKLE_MS = TICKLE.
#define TOUCH_TICKLE_COUNT 3
#define TOUCH_TICKLE_MS 1500
#define TOUCH_PURR_EVERY_MS 1400  // while petted, it purrs this often

// ---------------------------------------------------------------------------
// Microphone (FEATURE_MIC). Levels are mean |sample - DC| over a 10 ms
// block, in raw 12-bit ADC counts. PLACEHOLDERS until tuned on the bench:
// mic.c logs every sound it hears (level, length, class) to tune from.
// ---------------------------------------------------------------------------
#define MIC_SAMPLE_HZ 8000
#define MIC_BLOCK 80             // samples per block = 10 ms
#define MIC_ABSENT_MAX 300       // boot: DC below this = no mic on the pin
#define MIC_MIN_LEVEL 40         // never a sound below this, however quiet the room
#define MIC_SNR 3                // ...nor below the noise floor times this
#define MIC_END_GAP_MS 150       // a sound ends after this much quiet (gaps between words)
#define MIC_CLAP_MAX_MS 120      // a clap is short...
#define MIC_CLAP_LEVEL 250       // ...and sharp
#define MIC_DOUBLE_MS 600        // second clap within this = DOUBLE_CLAP
#define MIC_HEAR_MS 250          // a sound this long, not loud: a voice, it listens
#define MIC_TALK_MAX_MS 6000     // longer than this is noise or music: ignored
#define MIC_LOUD_LEVEL 500       // a long sound this loud is a shout
#define MIC_CLIP_LO 60           // samples near the rails: overloaded mic
#define MIC_CLIP_HI 4030
#define MIC_BLOW_CLIP_PCT 30     // blocks this often overloaded = blowing on it
#define MIC_ECHO_MS 250          // deaf while the buzzer plays, and this long after
#define MIC_AFTER_BODY_MS 1000   // claps and bangs right after a tap, button or shake are those

// ---------------------------------------------------------------------------
// Buttons
// ---------------------------------------------------------------------------
#define BTN_DEBOUNCE_MS 25
#define BTN_LONG_MS 600  // LONG fires while still held, SHORT on release before this

// ---------------------------------------------------------------------------
// LIS3DH: tap in hardware (click unit, INT1), shake and tilt in software
// ---------------------------------------------------------------------------
// Click threshold in LSB of 31 mg (+-4 g range), after the high-pass filter.
// Lower = more sensitive. 20-40 is the usual range at +-4 g.
#define ACCEL_TAP_THS 24  // bench 2026-10-25: 30 missed finger taps, 20 too jumpy
#define ACCEL_TAP_LIMIT 16    // max tap length, 5 ms units at 200 Hz (80 ms)
// Taps are grouped in software (motion_logic.c): on the bench one finger tap
// made the board ring and the click unit fired 3-5 times, 30-60 ms apart, and
// its own double-click detection never triggered.
#define ACCEL_TAP_RING_MS 80     // a click this soon after the previous click is ringing
#define ACCEL_TAP_DOUBLE_MS 450  // a second tap within this of the first = DOUBLE_TAP
// Pressing a button jolts the board and the LIS3DH reads it as a tap: taps
// are dropped while a button is held and for this long after a button event.
#define TAP_AFTER_BUTTON_MS 600

// Shake: SHAKE_HITS samples whose |a| is more than SHAKE_DEV_MG away from 1 g,
// all within SHAKE_WINDOW_MS. Taps and tilt are ignored for COOLDOWN after;
// shaking on reports another SHAKE every REPEAT or so (~0.8 s), which is how
// the face's anger climbs to a KO in 3-4 s of shaking.
#define ACCEL_SHAKE_DEV_MG 900
#define ACCEL_SHAKE_HITS 4
#define ACCEL_SHAKE_WINDOW_MS 1000
#define ACCEL_SHAKE_COOLDOWN_MS 1500
#define ACCEL_SHAKE_REPEAT_MS 600
// Any sample this far from 1 g keeps polling fast for a second, so a shake
// that starts between two idle frames is still sampled at ~30 Hz.
#define ACCEL_ACTIVE_DEV_MG 250

// Tilt: which axis points left-right on the face (0 = X, 1 = Y, 2 = Z) and
// its sign. Samples are in the screen frame (x right, y up, z out) once the
// menu's SETUP has calibrated the sensor; tilting right then reads -x, so
// the sign is -1. Before calibration the board's own axes are used as they
// are, and the direction may be wrong: run SETUP.
#define ACCEL_TILT_AXIS 0
#define ACCEL_TILT_SIGN (-1)
#define ACCEL_TILT_ENTER_MG 500  // ~30 degrees
#define ACCEL_TILT_EXIT_MG 250   // ~15 degrees, back to level
#define ACCEL_TILT_HOLD_MS 300

// ---------------------------------------------------------------------------
// Sound (FEATURE_SOUND): passive buzzer on PIN_BUZZER
// ---------------------------------------------------------------------------
// PWM duty in percent; 50 is loudest, lower is quieter (roughly).
#define SOUND_DUTY_PCT 50
// 1 for a 3-pin module with its own PNP transistor that beeps when I/O is low
// ("low level trigger"); 0 for a bare buzzer or one behind our NPN.
#define SOUND_ACTIVE_LOW 0
// GPIO drive strength 0-3 (~5 / 10 / 20 / 40 mA). The buzzer is wired straight
// to the pins with no transistor (Sasha has none), so the drive is what limits
// a coil buzzer's current. Bench 2026-10-25: 1 and 2 too quiet even at the
// buzzer's resonance; 3 is loud enough. Beeps are short, but this is the most
// a bare pin should do: a transistor is the real fix.
#define SOUND_DRIVE_CAP 3

// ---------------------------------------------------------------------------
// Power policy
// ---------------------------------------------------------------------------
// Contrast 0-255. The panel's current scales with it; faces are readable at
// very low values indoors. Awake, the menu's brightness picks it (app_contrast).
#define CONTRAST_NIGHT 0x01
#define CONTRAST_LOWBAT 0x01

// Frame pacing. While something moves (blink, glance, yawn) we redraw at
// ~30 fps; while the face is still we only wake 5x a second.
#define FRAME_MS_ANIMATING 33
#define FRAME_MS_IDLE 200

// Burn-in: the whole face moves to the next offset of a small loop this often.
#define BURNIN_SHIFT_MS (3UL * 60UL * 1000UL)
#define BURNIN_MAX_SHIFT_PX 2

// Sleep. There is no wall clock, so "night" is nobody touching it: after
// SLEEP_AFTER_MS without input it dozes off (dim, eyes shut, deaf). Any input
// wakes it, and so does picking it up (a move of WAKE_MOVE_MG between two
// accelerometer samples). Lying face down (screen frame z below FACEDOWN_MG
// for FACEDOWN_HOLD_MS) turns the screen off as well; lifting it wakes it.
// Face-down needs the calibration (Settings > Calibrate).
#define SLEEP_AFTER_MS (10UL * 60UL * 1000UL)
#define WAKE_MOVE_MG 300
#define FACEDOWN_MG (-750)
#define FACEDOWN_EXIT_MG (-450)
#define FACEDOWN_HOLD_MS 1500

// Battery (only used with FEATURE_BATTERY_ADC).
#define BATTERY_SAMPLE_MS (30UL * 1000UL)
#define BATTERY_DIVIDER_RATIO 2  // 5.1k over 5.1k
// Above this the 5V pin is fed by USB, not the cell. USB reads ~5470 here and
// with the ADC and resistor error a full cell can read above 4450 (it did).
#define BATTERY_MV_USB 5000
#define BATTERY_MV_EMPTY 3300    // what we call 0 %; DW01 cuts off ~2.4 V
#define BATTERY_MV_FULL 4150
#define BATTERY_MV_LOW 3500      // show the icon as low
#define BATTERY_MV_CRITICAL 3350 // show the low-battery face and deep sleep
#define CHARGE_DEBOUNCE_MS 300  // the charger cable must stay in (or out) this long to count

// How long the low-battery face stays up before the device deep-sleeps.
#define LOWBAT_FACE_MS 4000
// ...and when it wakes to try again. A brownout is not proof of an empty
// cell (slide-switch bounce at power-on can cause one), so sleeping forever
// would leave a full keychain dead until the switch is cycled. A really empty
// cell just browns out again on the retry, which costs about a second awake.
#define LOWBAT_RETRY_MS (10UL * 60UL * 1000UL)

// ---------------------------------------------------------------------------
// Face timing
// ---------------------------------------------------------------------------
#define BLINK_MIN_MS 2000
#define BLINK_MAX_MS 6000
#define BLINK_DURATION_MS 180

#define IDLE_BEHAVIOR_MIN_MS 6000   // gap between glances / yawns
#define IDLE_BEHAVIOR_MAX_MS 15000

#define MOOD_MIN_MS 8000            // how long a spontaneous mood holds
#define MOOD_MAX_MS 25000
