bilskyi/yeti-keychain/main/input/input_event.h

// Everything the face can react to, whatever produces it.
//
// Sources (buttons, LIS3DH, later BLE) translate their hardware into these
// events; the face and the power policy only ever see the events. Adding a new
// input is therefore a new source file, never a change to the face.
//
// Pure C, no ESP-IDF, so the face and the host tests can include it.

#pragma once

typedef enum {
    INPUT_NONE = 0,

    // LIS3DH (FEATURE_ACCEL)
    INPUT_TAP,
    INPUT_DOUBLE_TAP,
    INPUT_SHAKE,
    INPUT_TILT_LEFT,
    INPUT_TILT_RIGHT,

    // Touch pad on the head (FEATURE_TOUCH)
    INPUT_TOUCH,       // a short touch
    INPUT_TOUCH_HOLD,  // held: fires once, while still touching (petting)
    INPUT_TOUCH_END,   // let go after a HOLD
    INPUT_TICKLE,      // several quick touches in a row

    // Microphone (FEATURE_MIC)
    INPUT_CLAP,
    INPUT_DOUBLE_CLAP,
    INPUT_LOUD,  // a shout, a long bang
    INPUT_BLOW,  // blowing on the mic
    INPUT_HEAR,  // someone started talking: it listens
    INPUT_TALK,  // ...and stopped (input_mic_syllables() says how much they said)

    // Buttons (FEATURE_BUTTONS)
    INPUT_BTN_A_SHORT,
    INPUT_BTN_A_LONG,
    INPUT_BTN_B_SHORT,
    INPUT_BTN_B_LONG,
    INPUT_BTN_C_SHORT,
    INPUT_BTN_C_LONG,
    // The moment a button goes down (debounced), before short/long is known.
    // Games use these for timing; the face ignores them.
    INPUT_BTN_A_PRESS,
    INPUT_BTN_B_PRESS,
    INPUT_BTN_C_PRESS,

    INPUT_EVENT_COUNT
} input_event_t;

const char *input_event_name(input_event_t ev);
