bilskyi/yeti-keychain/(commit log)

2026-10-23 Phase 1: v0.1 firmware - face engine, input plumbing, power policy
    SH1106/SSD1306 driver with dirty-range flush, 7 expressions with blink,
    glance and yawn, mood state machine, input event queue and dispatcher,
    night mode stub, burn-in shift, brownout/low-battery path, battery stub.
    Host tests and face preview under host/.
    [accel_lis3dh.c, battery.c, battery.h, battery_logic.c, battery_logic.h, buttons.c, config.h, display.c]
2026-10-23 Record 300 mAh cell and 100k divider
2026-10-23 Record: battery wiring deferred
2026-10-23 Phase 3 v0: parametric case with placeholder dimensions
    Shell, lid and button caps in OpenSCAD, all sizes in case/params.scad.
    build.sh exports STLs and previews; check.py verifies clearances and
    watertightness.
    [caps.stl, keychain_case.scad, lid.stl, params.scad, shell.stl]
2026-10-23 Case: robot-head style
    Antenna keyring loop, hex-bolt ears, recessed visor, engraved button
    panel and rivets, side vents, KC-01 serial plate on the lid. All front
    detail engraved so the shell still prints face down without supports.
    Fixes the upside-down front preview and documents that +X is the left
    side seen from the front.
    [keychain_case.scad, lid.stl, params.scad, shell.stl]
2026-10-23 Case: three outer-form concepts (TV, helmet, ghost) to choose from
    [concepts.scad]
2026-10-23 Case: three more concepts (arcade, cat, cassette)
    [concepts.scad]
2026-10-23 Case: funny concepts (burger, toast, poop emoji)
    [concepts.scad]
2026-10-23 Case: Boltik, a goofy robot that prints without supports
    Big rounded head, lightning-bolt antenna as the keyring loop, dish and
    bolt ears, noodle arms, stubby legs, engraved bandage and DON'T PRESS,
    WARRANTY VOID IF ANNOYED and a wind-up key on the back. Design rules are
    asserted in the model; check.py adds rounded-corner clearance and an
    STL overhang/bridge report.
    [key.stl, keychain_case.scad, lid.stl, params.scad, shell.stl]
2026-10-23 Case: Boltik v2, a round 3D robot in two printed shells
    Body prints back down and the face plate face up, so every visible
    surface can be round or raised without supports. Pill-profile limbs,
    raised bezel, rivet screws, bandage, blush and DON'T PRESS on the plate,
    two M2 screws through the OLED's top holes into bosses.
    check.py: fit is now checked in real 3D by intersecting each grown part
    with the printed solids; bridge width uses 4*area/perimeter so thin
    grooves are not mistaken for wide bridges.
    [body.stl, caps.stl, key.stl, keychain_case.scad, lid.stl, params.scad, plate.stl, shell.stl]
2026-10-23 Case: Boltik v3, a sitting robot with centred, posable limbs
    Arms and ears are separate teardrop-profile parts on M2 screws at the
    head's mid-depth (arms posable); legs are separate, pinned to the face
    plate with filament and stretched forward so it sits. Keyring is a
    thick ring on top, part of the body. Switch moved to the back.
    [arm_l.stl, arm_r.stl, body.stl, ear_bolt.stl, ear_dish.stl, keychain_case.scad, leg.stl, params.scad]
2026-10-23 Yeti: three belly buttons for the downloaded Yeti body
    yeti_buttons.scad cuts three pockets, square to the sloped belly, into
    the original body (solid 8.5-9 mm there): floor takes the press, leg
    slots into the cavity, caps cover the pocket. Adds no support needs
    compared with the original. The original STLs stay local and untracked.
    [yeti_body_buttons.stl, yeti_buttons.scad, yeti_caps.stl]
2026-10-23 Yeti: assume the common 6x6x5 buttons
    [yeti_buttons.scad]
2026-10-23 Yeti: battery power via an electronics carrier and new back plate
    The original Yeti has no battery and its tray's front wall sits behind
    the belly buttons. Replace the tray with a carrier screwed to a new back
    plate: Super Mini and TP4056 on two shelves with stacked USB-C ports,
    LiPo on the flange, switch through the plate, fingers backing the OLED.
    Fit probed against the real body mesh; both parts print without support.
    [yeti_back_plate.stl, yeti_carrier.stl, yeti_power.scad]
2026-10-24 Yeti: outside-look renders; fill the old USB recess flush
    yeti_look.scad renders the finished Yeti (belly buttons, new back plate,
    a face on the screen). The filled original USB hole left a seam: its
    recess sat 0.85 mm higher than assumed; the fill now covers it flush.
    [yeti_back_plate.stl, yeti_buttons.scad, yeti_look.scad, yeti_power.scad]
2026-10-24 Yeti back plate: stadium-shaped USB-C ports with a lead-in chamfer
    Ports were plain rectangles; they now follow the receptacle's rounded
    shape. The fit check models the receptacles as stadiums too. Fixes a
    variable-shadowing bug that had narrowed the board pockets, and sinks
    the old-port fill 0.02 mm to avoid sliver triangles.
    [yeti_back_plate.stl, yeti_power.scad]
2026-10-24 Yeti look: show the original 1.3in bezel insert and the glass behind it
    [yeti_look.scad]
2026-10-24 Yeti: assemble the print pack (binary STLs, README, previews)
2026-10-25 Phase 2: buttons, LIS3DH and buzzer, verified on the bench
    - Buttons A/B/C (GPIO1/3/5): level IRQ doubles as light-sleep wake,
    debounce + short/long in button_logic.c, A wakes from deep sleep.
    - LIS3DH (0x18/0x19): hardware single click on INT1, read every frame;
    ringing filter and double tap in software; shake and tilt from samples
    (motion_logic.c). Taps around a button press are dropped.
    - Buzzer (FEATURE_SOUND, GPIO10): LEDC on the XTAL clock, chirps per
    reaction at 1.5-4 kHz, BTN_B_LONG mutes; optional bridge on GPIO20.
    - Main loop waits in input_wait() so an interrupt ends an idle frame.
    - Host input_test (mutation-checked); docs and PROGRESS updated.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
    [accel_lis3dh.c, button_logic.c, button_logic.h, buttons.c, config.h, input.c, input.h]
2026-10-25 Face: "Mochi dots" redesign with new expressions and 2-button controls
    - Small round eyes set wide apart and a bold smile (Sasha's reference),
    eyes r=10 after a check on the panel.
    - New expressions: SAD (mood, more often when ignored), LAUGH, DIZZY, KO,
    EXCITED, WINK (reactions). Each animates for a short window only, so the
    loop drops back to 5 fps.
    - Shake = dizzy, shake while dizzy = KO; A = pet (random cheerful face),
    B = step through every face; tilt still looks.
    - Tests for the new reactions and the end of animation.
    [face.c, face.h, mood.c]
2026-10-26 v0.3 + v0.4: menu, games and pet life
    v0.3: B long opens a menu; Dice, Coin, Reaction, Catch (tilt) and Flappy;
    sound on/off in the menu; best scores in NVS; 5x7 font; press-down button
    events for game timing.
    v0.4: a Tamagotchi layer (food, fun, energy, XP and levels, saved in NVS)
    whose needs drive the mood and a thought bubble; two-level menu with FEED,
    PET stats, SLEEP and SETUP; Snake and Memory; the face follows tilt, panics
    upside down, says hi when picked up, whee when dropped, sneezes and hums;
    SETUP calibrates the LIS3DH into a screen frame. NVS record v2 migrates v1.
    Host tests cover the menu, every game, the pet, calibration and the face's
    body sense. Flashed; boot log clean.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
2026-10-26 v0.5 + EMO face: backstory, LED siren, songs, simpler controls
    - YETI-7 lore: siren alarm when the pet needs something (buzzer, red LED
    on GPIO20, flashing screen), random glitches with log lines, random
    RTTTL songs you shake to stop; jukebox under GAMES > MUSIC.
    - Controls: on the face A = pet, B = menu; hint line on every screen;
    SLEEP only from the menu.
    - EMO-style face: no mouth, big rounded pill eyes (32x42) carry every
    emotion; all special eyes scaled to match.
    [app.c, app.h, app_internal.h, config.h, face.c, face.h]
2026-10-27 Reactions, petting, animations, mic and touch; button C, flipped screen
    - Shake ladder (cross, furious, KO, sulk), petting sequence timed to the
    TTP223's 7 s limit, tickle roll, hangs fixed by shaking, idle scenes.
    - MAX4466 mic and TTP223 touch inputs.
    - Red LED removed; buttons left to right are A/B/C on GPIO20/3/1.
    - OLED mounted rotated 180 degrees (DISPLAY_UPSIDE_DOWN).
    - Boot check that flags SDA/SCL held low or shorted together.
    [app.c, app.h, buttons.c, config.h, display.c, face.c, face.h]
2026-11-06 v0.6: new games, BIT voice link, Wi-Fi update page, new yeti case files
    Games: egg, maze, pong, toss, voice, music visualiser; dice and setup replace
    luck and care. Link to BIT (bitlink, buddy, pong over the air), an access
    point update page with an OTA partition table, a printable guide, release
    binaries in dist/. The case's current print files live in case/yeti/latest;
    their STLs stay out of git until the original model's licence is checked.
    [partitions.csv]
2026-11-09 Add the current yeti print files (case/yeti/latest/print)
    [1_body_with_3_buttons.stl, 2_back_plate_1xUSB-C_switch.stl, 4_button_caps_x3.stl, 5_screen_bezel_1.3in_original.stl]
2026-11-10 README: case renders, faces, games and music screens
